wennycooper/myRCCar/circuit-design.html

專案規劃 · 藍芽遙控車

# Arduino 藍芽遙控車 — 電路設計

雙輪驅動車體 + TB6612FNG 馬達驅動 + HC-05 藍芽模組 + App Inventor，全部共用一組 4×1.5V 電池盒供電（Arduino Uno）。下面先把電路跟接腳定下來，你照著插好麵包板、完成 (a)(b) 兩階段測試沒問題後，我們再進到藍芽跟 App Inventor 的部分。

## 四個階段

a

### 馬達正反轉測試

兩顆 TT 馬達各自正轉、反轉，確認 TB6612 接線方向正確。

b

### 動作邏輯

寫成前進 / 後退 / 左轉 / 右轉函式，車體實際跑跑看。

c

### 藍芽遙控

接上 HC-05，App Inventor 四個方向按鈕即時控制。

d

### 漸進加減速

按住加速、放開減速，PWM 隨時間平滑變化。

## 電源共用注意事項

### 你選的是「4 顆電池同時供電 Arduino + 馬達」

- Uno 內建穩壓 IC 建議 Vin 至少 7V 才穩定，6V 已經在邊緣。馬達啟動瞬間電流突增會讓電壓下垂（sag），可能讓 Arduino 重開機——常見症狀是藍芽突然斷線、程式像是「從頭重跑」。
- 建議在 TB6612 的 VM／GND 腳位附近、麵包板電源軌上，並聯一顆 100～470µF 電解電容，緩衝馬達啟動瞬間的電流尖峰（電容長腳接正極、短腳接負極，別接反）。
- 盡量用新的鹼性電池。如果之後常常無預警重開機，先換電池排除電力問題；還是不行的話，再考慮把 Arduino 改成 USB 供電、電池只留給馬達。

## 零件清單

零件 | 數量 | 備註
Arduino Uno | 1 | —
TB6612FNG 馬達驅動模組 | 1 | —
HC-05 藍芽模組 | 1 | 已內建 RX 分壓，直接對接即可
TT 馬達（含輪子） | 2 | 已測試通過
4×1.5V 電池盒（6V） | 1 | 建議用新電池
麵包板 + 杜邦線 | 1 組 | 公對母、公對公都準備一些
電解電容 100～470µF | 1（建議） | 接在 VM／GND 之間穩壓用

## 電路方塊圖

先看模組之間怎麼連，實際每一條線的腳位對應請看下面的接腳對照表。

+6V / 5V 電源 GND（共同地） 左馬達控制訊號 右馬達控制訊號 藍芽序列訊號

## 接腳對照表

這張表是實際插線時的依據，優先看這張表，圖只是幫你理解模組間的關係。

Arduino | 接到 | 說明
電源（共同地一定要接在一起）
Vin | 電池盒 (+) | 6V 主電源
GND | 電池盒 (−)、TB6612 GND、HC-05 GND | 共同地
5V | TB6612 VCC、HC-05 VCC | 邏輯電源（3.3～5V 元件用這條，不是電池直接的 6V）
藍芽（HC-05）— SoftwareSerial
D2 | HC-05 TXD | Arduino 收（軟體序列埠 RX）
D3 | HC-05 RXD | Arduino 送（軟體序列埠 TX）
TB6612FNG — 左馬達（A 側）
D4 | STBY | 一定要在 setup() 拉 HIGH，沒接或是 LOW 的話兩顆馬達都不會動
D5（PWM） | PWMA | 左馬達轉速
D7 | AIN1 | 左馬達方向控制 1
D8 | AIN2 | 左馬達方向控制 2
— | TB6612 AO1 / AO2 → 左馬達 | 接到左邊 TT 馬達的兩隻腳，正反隨意，測試時再對調
TB6612FNG — 右馬達（B 側）
D6（PWM） | PWMB | 右馬達轉速
D9 | BIN1 | 右馬達方向控制 1
D10 | BIN2 | 右馬達方向控制 2
— | TB6612 BO1 / BO2 → 右馬達 | 接到右邊 TT 馬達的兩隻腳

D5／D6 特別選有 PWM（~）標示的腳位，因為要拿來調速度。D2／D3 故意避開 D0/D1（那兩隻是 USB 燒錄程式用的序列埠，接了 HC-05 會導致上傳程式失敗），也避開 D4～D10 避免跟馬達驅動腳位衝突。

## 麵包板組裝建議順序

1. 先架好電源軌：麵包板正負軌接到電池盒——先不要放電池！
2. 插上三個模組：Arduino、TB6612FNG、HC-05 都先插上麵包板，只接 GND 跟電源腳位，用電表量一下電池 (+) 跟 GND 之間沒有短路。
3. 接訊號線：照上面對照表接 D2～D10。
4. 特別檢查 STBY：確認 D4 有接到 TB6612 的 STBY，這條漏接是最常見的「馬達完全不會轉」原因。
5. 先不接馬達，通電測試：放電池，Arduino 接電腦跑個簡單的 LED blink，確認開機穩定、不會因為電源不穩重開機。
6. 最後才接馬達：把左右 TT 馬達接到 AO1/AO2、BO1/BO2，準備進入 (a) 階段的正反轉測試。

下一步：電路照這樣接沒問題的話，跟我說一聲，我就給你 (a) 階段的測試程式——兩顆馬達分別正轉、反轉，用來驗證接線方向對不對。如果板子型號、電源方式想改，或是零件跟這裡假設的接腳排列不一樣，也直接告訴我，我再調整。

藍芽遙控車專案 · 電路規劃 v1
