wennycooper/myRCCar/(commit log)

2026-07-25 Add App Inventor project for (c) Bluetooth control stage
    Include exported .aia project, Designer/Blocks screenshots, and
    update the learning-journal README with the completed (c) stage.
2026-07-25 Scope project down to stages (a)-(c), drop planned (d) stage
    Decided the Bluetooth-controlled car with direction buttons met the
    project goal; documenting the decision to stop rather than continue
    into gradual accel/decel.
2026-07-25 Add build process photos to README
    Include photos from unboxing through final assembly, embedded in
    the relevant sections (parts, circuit, hands-on build) and the
    finished car as the top-of-README hero image.
2026-07-25 Add HC-05 pinout photo next to TB6612 in circuit design section
2026-07-26 Add Fritzing schematic and note learning Fritzing along the way
2026-07-30 新增展示影片並更新 README
2026-07-30 改用可點擊縮圖連結播放展示影片（GitHub 不會渲染 relative 路徑的 video 標籤）
2026-07-30 改用 YouTube 連結嵌入成果展示影片，放在成果圖下方
